EnergyHardwareBench/ehb-core/documentation/SUMMARY.md

# Table of contents

* [Projects](README.md)

## QUASAR-MS

* [Overview](quasar-ms/quickstart.md)
* [Mass Spectrometer & Vacuum System](quasar-ms/mass-spectrometer-and-vacuum-system.md)
* [Gas Processing & Sampling System](quasar-ms/gas-processing-and-sampling-system.md)
* [System Startup, and Tuning](quasar-ms/system-startup-and-tuning.md)
* [Calibration](quasar-ms/calibration.md)
* [Data](quasar-ms/publish-your-docs.md)
* [Taking a Measurement](quasar-ms/taking-a-measurement.md)
* [Tips + Tricks](quasar-ms/tips-+-tricks.md)
* [Support](quasar-ms/support.md)
* [Coming Soon](quasar-ms/coming-soon.md)

## Electrochemical Test Cells

* [Observable H Flow Cell](electrochemical-test-cells/observable-h-flow-cell.md)
* [Coming Soon](electrochemical-test-cells/coming-soon.md)
* [Editor](electrochemical-test-cells/editor.md)

## Resources

* [General Resources](resources/general-resources.md)
