EnergyHardwareBench/ehb-core/documentation/quasar-ms/coming-soon.md

---
description: List of Planned Changes
---

# Coming Soon

Thank you for your patience while we update documentation during our beta release. We plan to release more documentation by August 2026 on the following topics for QUASAR-MS.

* Detailed system startup, and tuning instructions
* Step-by-step calibration instructions and sample calibration data, data processing scripts for calibration
* Experimental methods, data collection instructions, software for data collection, scripts for data processing
* Scripts for testing individual hardware components, and plotting data
* Updated BoM for simplified version of QUASAR-MS
* Discord support server and github code repositories&#x20;
* Tips and tricks&#x20;

In the meantime, join our Email List or RSS Feed for updates!
