EnergyHardwareBench/ehb-core/documentation/quasar-ms/publish-your-docs.md

---
hidden: true
layout:
  width: default
  title:
    visible: true
  description:
    visible: true
  tableOfContents:
    visible: true
  outline:
    visible: true
  pagination:
    visible: true
  metadata:
    visible: true
  tags:
    visible: true
  actions:
    visible: true
  anchors:
    visible: true
---

# Data

**THIS IS ALSO WHERE WE EXPLAIN mdot - mdot etc ...**&#x20;

**Curves we will publish**

* calibration cruves and procedures
  * calibration procedure&#x20;
* stability curves—pressure stability and etc&#x20;
* reset time and rise time data
* Errors spreadsheet&#x20;
* Experiment example data
  * procedure for experiment... turn on turn off
* pump down and bakeout procedure and etc ...&#x20;

Sections order:

* Design details&#x20;
* BoM and CAD
* Assembly&#x20;
* Setup Calibration&#x20;
* Data
* Tips and Tricks
