EnergyHardwareBench/ehb-core/documentation/resources/general-resources.md

---
description: Links to General Resources of Value to the Electrochemistry Community
---

# General Resources

{% hint style="info" %}
More resources are coming soon!
{% endhint %}

#### Design Resources

[FUNdaMENTALs of Design](https://meddevdesign.mit.edu/fundamentals-of-design/)—a great resource on precision engineering design and ideation.&#x20;

#### XPS Characterization

These resources were shown to us by Libby Shaw at the MIT Materials Research Lab (MRL), thanks Libby!

[ThermoFischer Scientific XPS Database](https://www.thermofisher.com/us/en/home/materials-science/learning-center/periodic-table.html)

[NIST X-Ray Photoelectron Spectroscopy Database](https://srdata.nist.gov/)

[XPS Reference Pages](https://www.xpsfitting.com/)

#### Recommended Textbooks

Practical Electronics for Inventors, 4th Edition, Paul Scherz and Simon Monk

Principles of Power Electronics, John G. Kassakian, David J. Perreault, George C. Verghese, Martin F. Schlecht

Shigley's Mechanical Engineering Design, by Joseph Edward Shigley and Richard G. Budynas
