EnergyHardwareBench/ehb-core/documentation/.gitbook/assets/Asset 41@300x.png

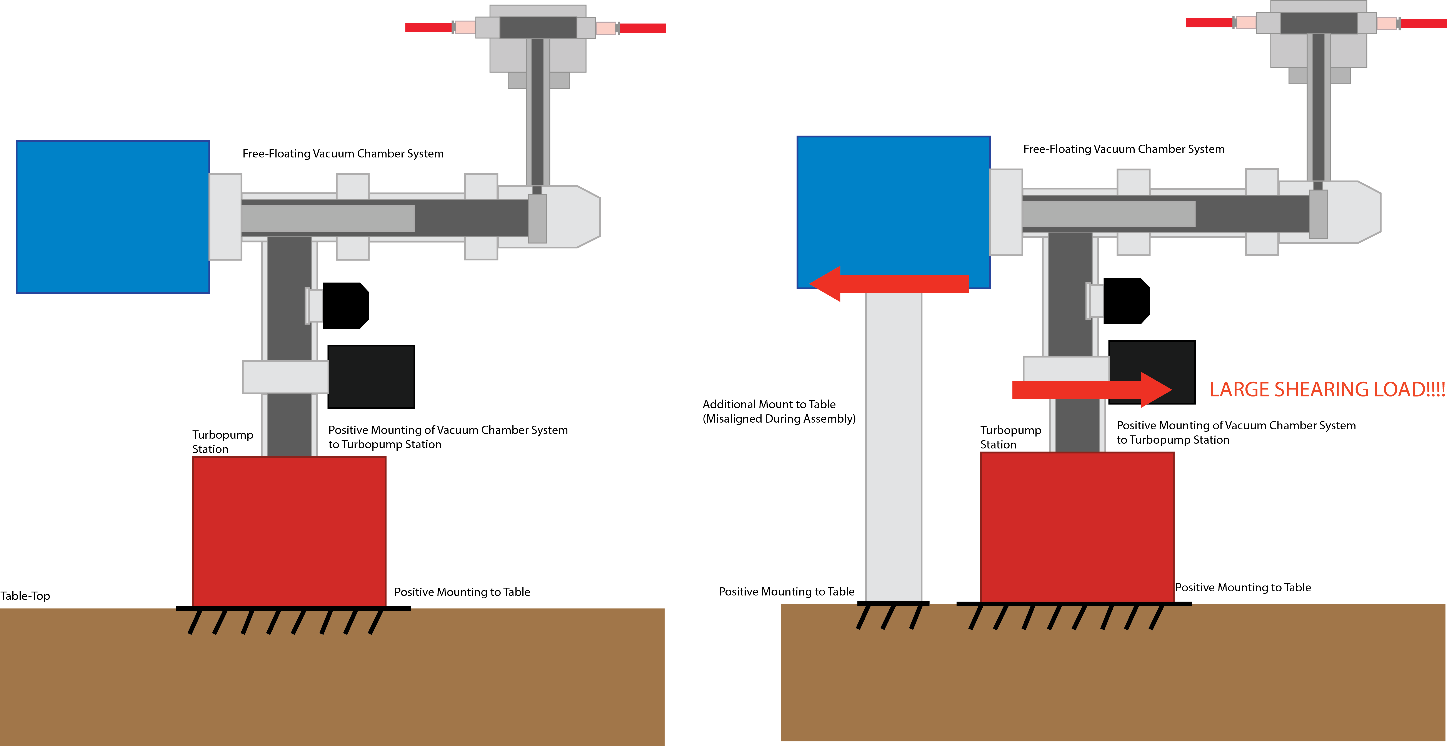
documentation/.gitbook/assets/Asset 41@300x.png
