EnergyHardwareBench/ehb-core/documentation/.gitbook/assets/Asset 56@300x.png

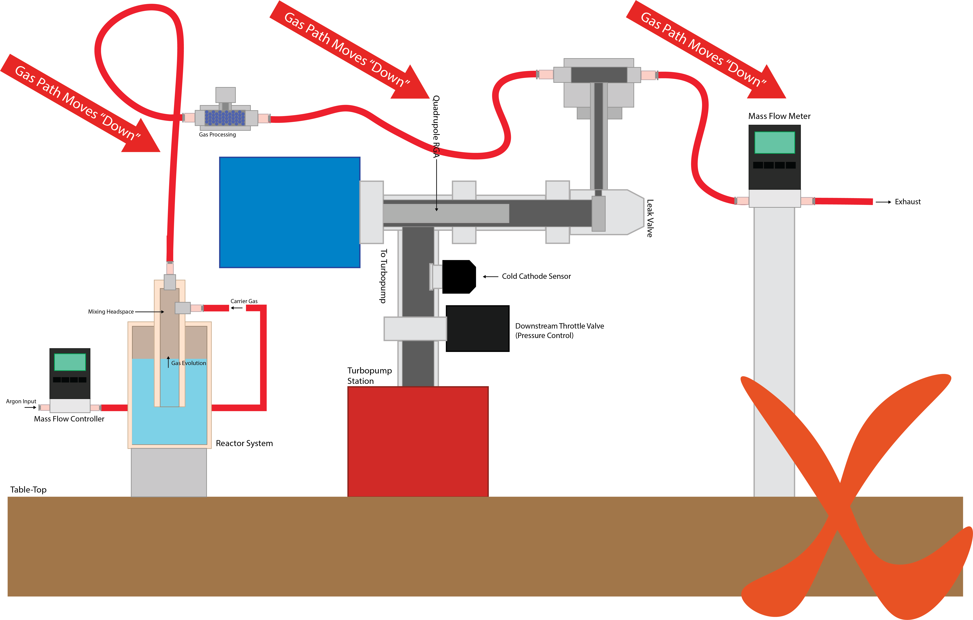
documentation/.gitbook/assets/Asset 56@300x.png
