EnergyHardwareBench/ehb-core/documentation/.gitbook/assets/Figure_2.png

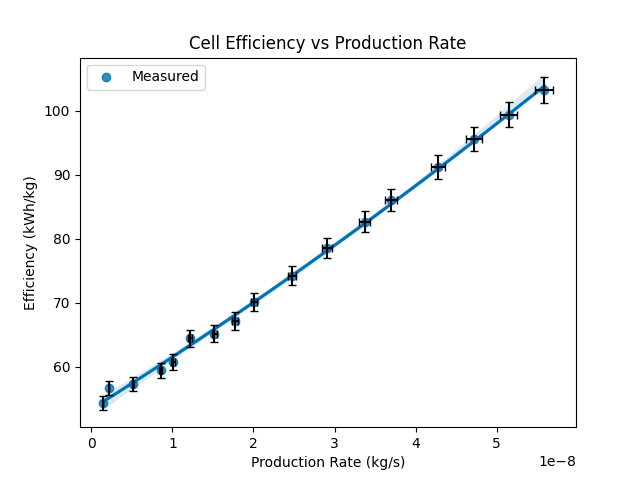
documentation/.gitbook/assets/Figure_2.png
