EnergyHardwareBench/ehb-core/documentation/.gitbook/assets/image (3).png

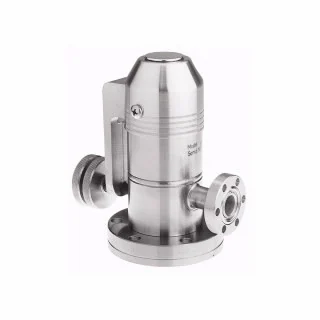
documentation/.gitbook/assets/image (3).png
