EnergyHardwareBench/ehb-core/documentation/.gitbook/assets/image (4).png

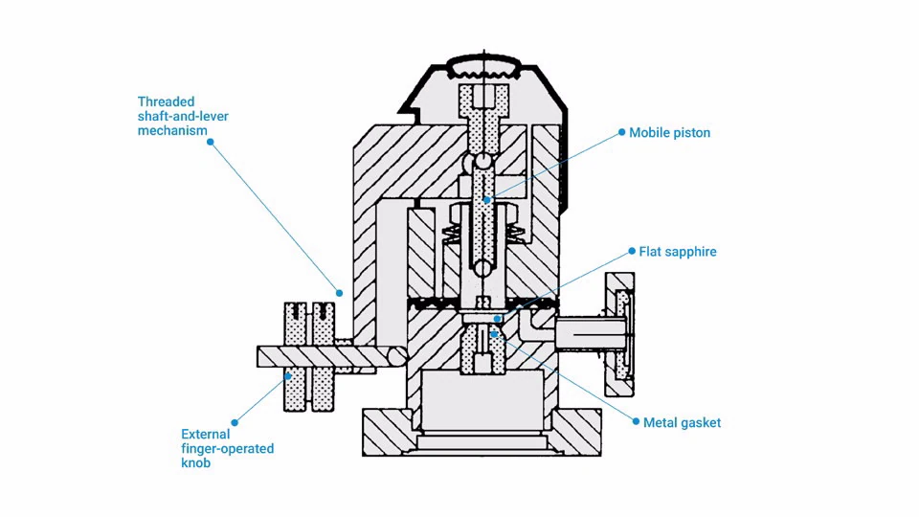
documentation/.gitbook/assets/image (4).png
