EnergyHardwareBench/ehb-core/documentation/.gitbook/assets/image (5).png

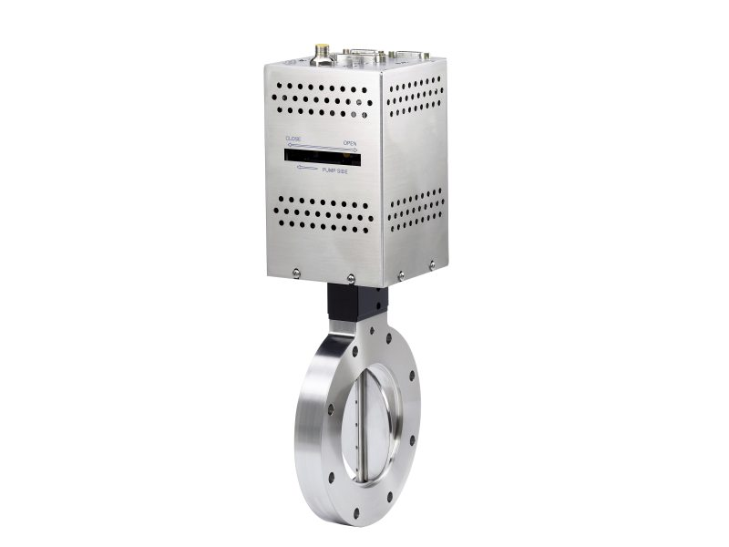
documentation/.gitbook/assets/image (5).png
