EnergyHardwareBench/ehb-core/documentation/.gitbook/assets/IMG_6685 (1).jpeg

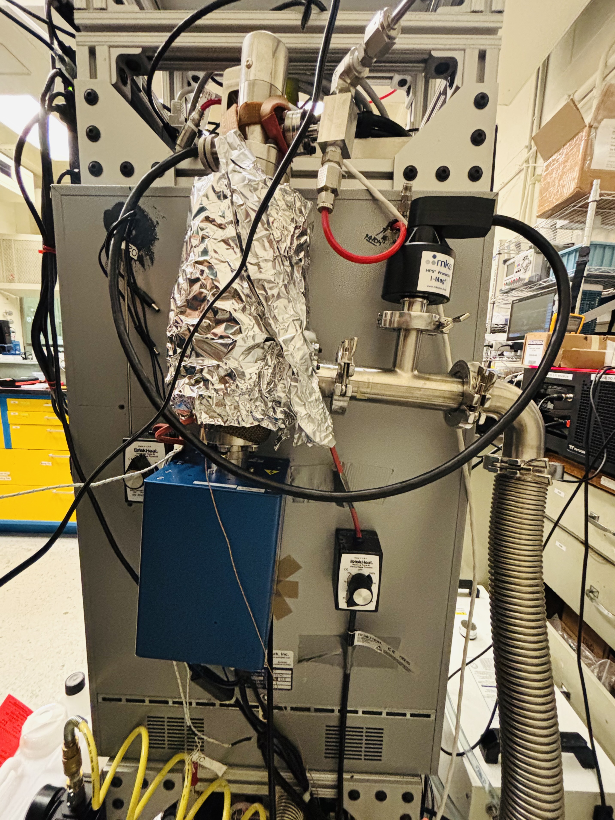
documentation/.gitbook/assets/IMG_6685 (1).jpeg
