EnergyHardwareBench/ehb-core/documentation/.gitbook/assets/section.png

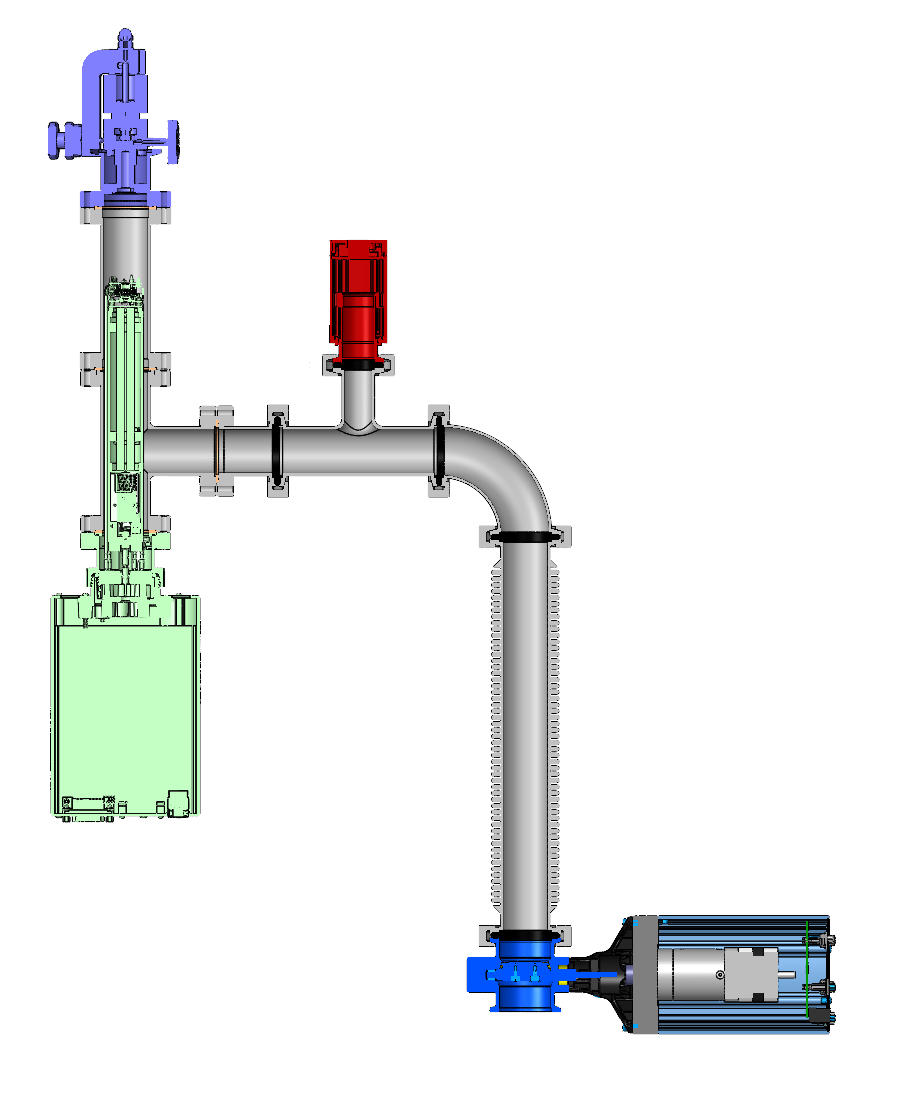
documentation/.gitbook/assets/section.png
