EnergyHardwareBench/ehb-core/thanks/untitled/.gitbook/assets/image.png

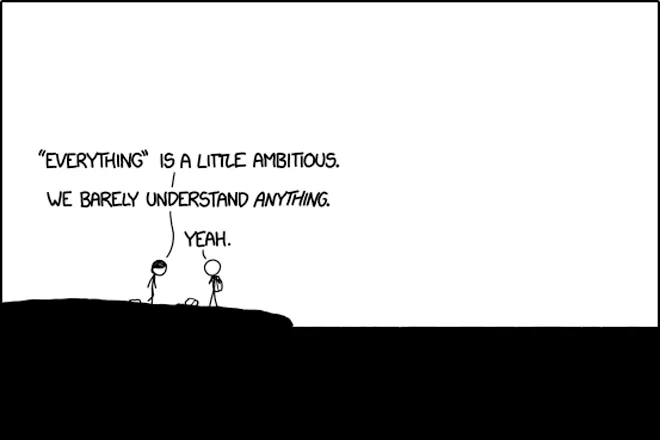
thanks/untitled/.gitbook/assets/image.png
