EnergyHardwareBench/ehb-core/documentation/.gitbook/assets/full_cell_assem.STEP

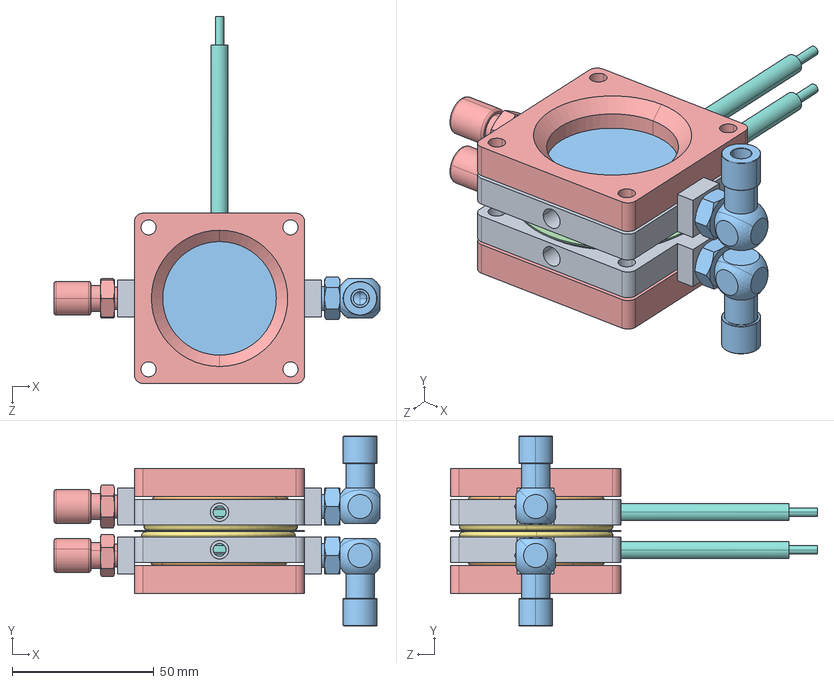
[picture p64: CAD file, 2026-10-14]
documentation/.gitbook/assets/full_cell_assem.STEP
114.8 x 66.8 x 129.3 mm
hydrogen_compartment x 2
2407N212_Stainless Steel Push-to-Connect Tube Fitting for Chemicals_2407N212 x 2
2407N122_Stainless Steel Push-to-Connect Tube Fitting for Chemicals_2407N122 x 2
9319K182_FEP-Encapsulated Silicone O-Ring_9319K182 x 2
9319K187_FEP-Encapsulated Silicone O-Ring_9319K187 x 2
electrode_holder x 2
nickle_electrode x 2
9319K155_FEP-Encapsulated Silicone O-Ring_9319K155 x 2
quartz_sheet x 2
zirfon_perl_500
end_caps x 2
