EnergyHardwareBench/ehb-core/documentation/.gitbook/assets/ST.SLDPRT

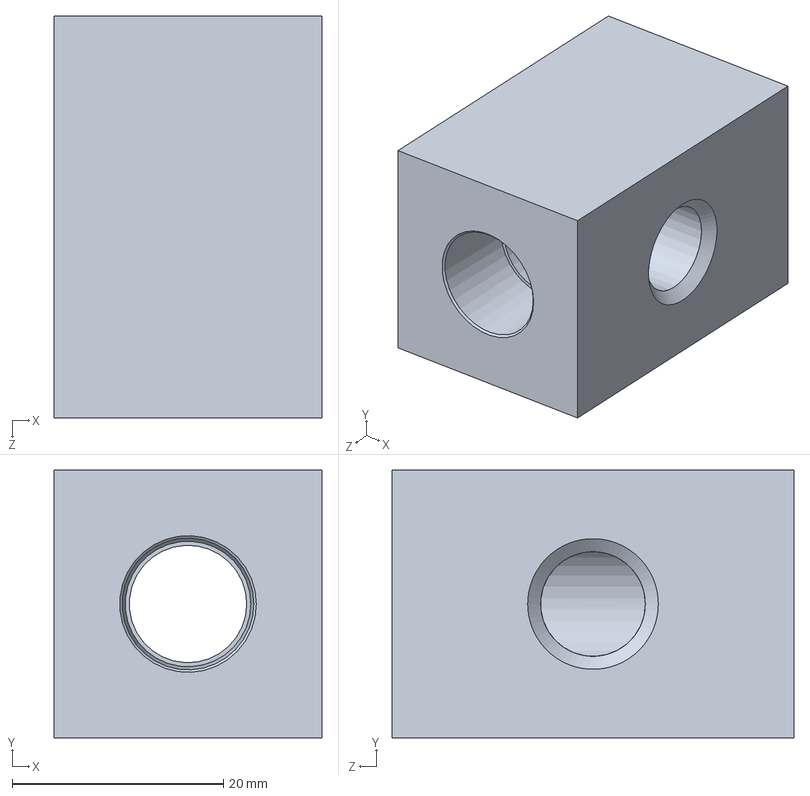
[picture p65: CAD file, 2026-10-14]
documentation/.gitbook/assets/ST.SLDPRT
25.4 x 25.4 x 38.1 mm
