EnergyHardwareBench/ehb-core/documentation/electrochemical-test-cells/coming-soon.md

---
description: List of Planned Changes
---

# Coming Soon

Thank you for your patience while we update documentation during our beta release. We plan to release more documentation by August 2026 on the following topics for Electrochemical Test Cells.

* Detailed characterization data for the flow H-Cell including polarization and efficiency curves, CV curves, and EIS data.
* Design documentation for the full bubbler-pump system for the mini electrolysis system.&#x20;

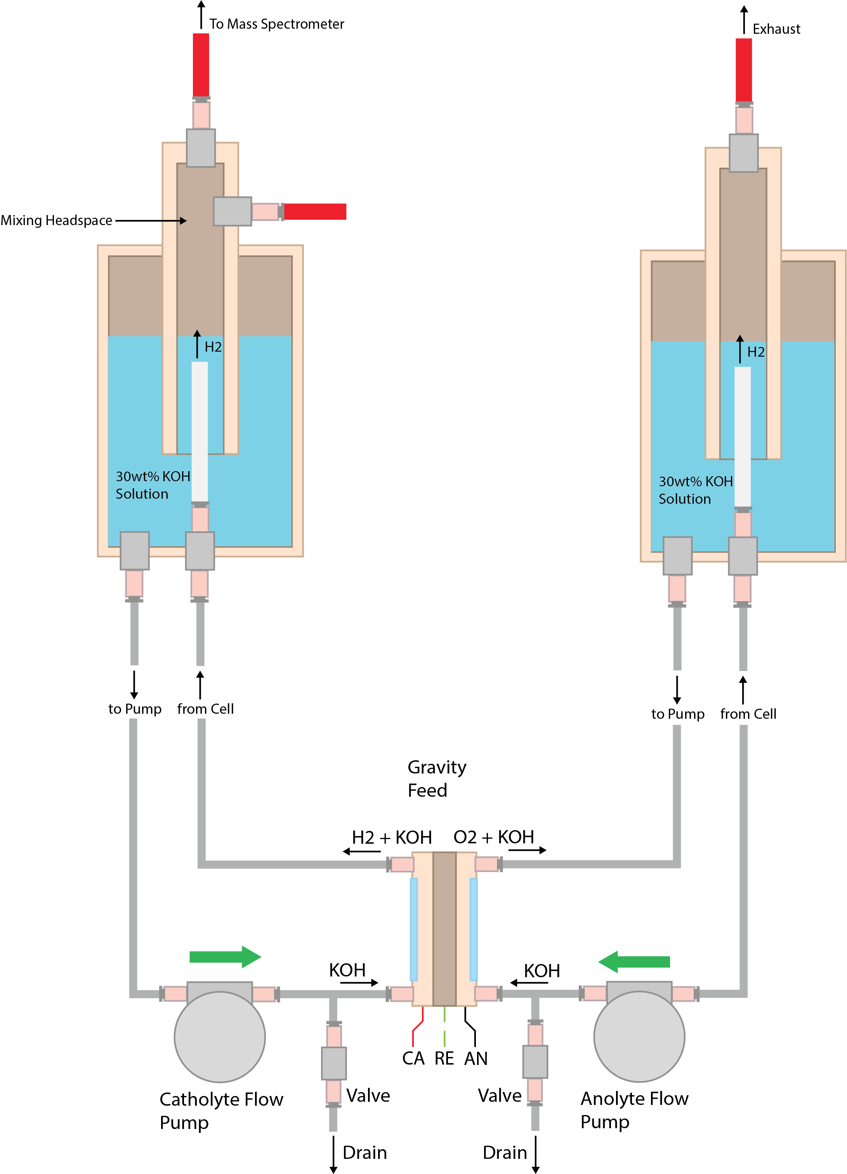
[picture p66: documentation/.gitbook/assets/Asset 74@300x.png]
<figure><figcaption></figcaption></figure>

* Deatiled design of operando cells and coupling of cells to operando characterization equipment and the QUASAR-MS.

In the meantime, join our Email List or RSS Feed for updates!
