EnergyHardwareBench/ehb-core/documentation/electrochemical-test-cells/editor.md

---
hidden: true
icon: pen-to-square
layout:
  width: default
  title:
    visible: true
  description:
    visible: true
  tableOfContents:
    visible: true
  outline:
    visible: true
  pagination:
    visible: true
  metadata:
    visible: true
  tags:
    visible: true
  actions:
    visible: true
  anchors:
    visible: true
---

# Editor

**POINTS TO MAKE**

* the windows are interchangeable !&#x20;
  * sapphire or quartz&#x20;
* O-rings are replaceable, compression is correct
  * how often to replace them!!!!
* Compatibility matrix with key electrolytes&#x20;

**add the bubbler situation !**&#x20;

and simultaneously?&#x20;

while also being compatible with surface-sensitive techniques such as Raman/SERS/SEIRAS spectrometers

* Coupling to operando equipment
* &#x20;simultaneous coupling to raman&#x20;
* translatability to the beamline&#x20;

Along with easier coupling to , open-source test cells provide a standardized platform for widely-studied reactions. With the design of

_STANDARDIZED TEST CELLS WITH KNOWN PUBLISHED DATA CURVES ..._&#x20;

* publish ALL the data!!!&#x20;

**Data we will publish**

* CV Curves — with scan rate and REF electrode data etc&#x20;
* EIS at different overpotentials&#x20;
* Electrode prep procedure&#x20;
* ex-situ XPS data; and electrode prep procedure for XPS&#x20;
* Polarization cruve of the cell
* efficiency curve&#x20;
* overpotentials with respect to the RE&#x20;
* pressures in the chamber (like EVERYTHING WE PLOT)
* FE with respect to average current&#x20;
