EnergyHardwareBench/ehb-core/documentation/quasar-ms/calibration.md

---
hidden: true
---

# Calibration

### System Error Analysis
