EnergyHardwareBench/ehb-core/documentation/quasar-ms/taking-a-measurement.md

---
hidden: true
---

# Taking a Measurement

**HIGH SAMPLING RATE ON THE MFM**&#x20;

**OR THE USE OF NON-PERISTALTIC PUMPS !!! KNF FOR EXAMPLE!!!**&#x20;
