EnergyHardwareBench/ehb-core/updates/changelog/README.md

---
description: >-
  Key updates on new project and project status; log of "breaking changes" to
  software or critical hardware updates. Subscribe to the EHB RSS feed for
  notifications.
icon: clock-rotate-left
layout:
  width: wide
  title:
    visible: true
  description:
    visible: true
  tableOfContents:
    visible: false
  outline:
    visible: true
  pagination:
    visible: false
  metadata:
    visible: true
  tags:
    visible: true
  actions:
    visible: true
  anchors:
    visible: true
---

# Updates

{% updates format="full" %}
{% update date="2026-08-25" %}
## Hardware Submissions now Open

* We welcome any and all contributors to submit hardware documentation to be published on our site. Thank you for making energy science and education more accessible for all!
* Check out the [hardware submission form](https://forms.cloud.microsoft/pages/responsepage.aspx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\&route=shorturl) for full list of details, guidelines, and requirements.
{% endupdate %}

{% update date="2026-05-27" %}
## EHB Public Beta Released

* Initial documentation on QUASAR MS and Electrochemical Cells released, data, software, and detailed documentation set to release later this summer.&#x20;
* Please contact us at [hardware@mit.edu](mailto:hardware@mit.edu) for more information.
{% endupdate %}
{% endupdates %}
