EnergyHardwareBench/ehb-core/updates/changelog/SUMMARY.md

# Table of contents

* [Updates](README.md)
