EnergyHardwareBench/ehb-core/documentation/.gitbook/assets/IMG_6688.jpeg

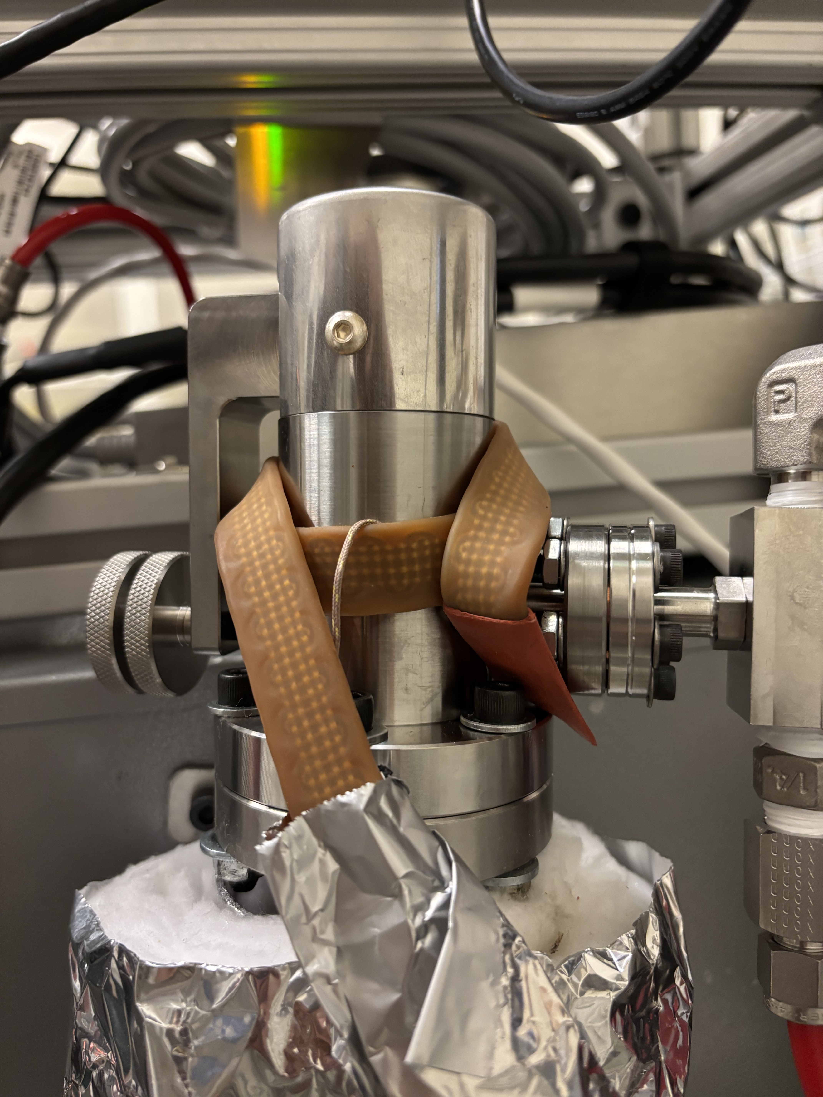
[picture p12: documentation/.gitbook/assets/IMG_6688.jpeg]
documentation/.gitbook/assets/IMG_6688.jpeg
