EnergyHardwareBench/ehb-core/documentation/.gitbook/assets/IMG_6692.jpeg

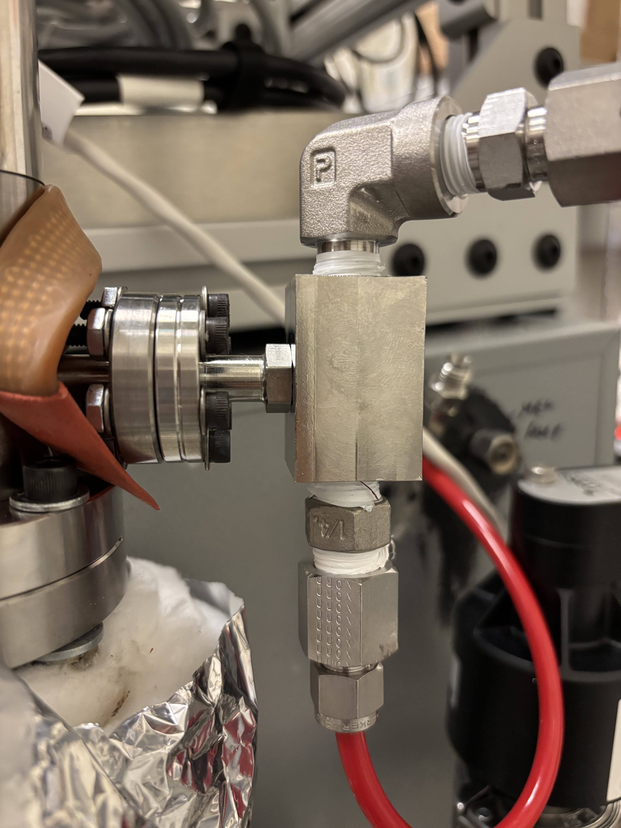
[picture p17: documentation/.gitbook/assets/IMG_6692.jpeg]
documentation/.gitbook/assets/IMG_6692.jpeg
