EnergyHardwareBench/ehb-core/documentation/.gitbook/assets/IMG_6696.jpeg

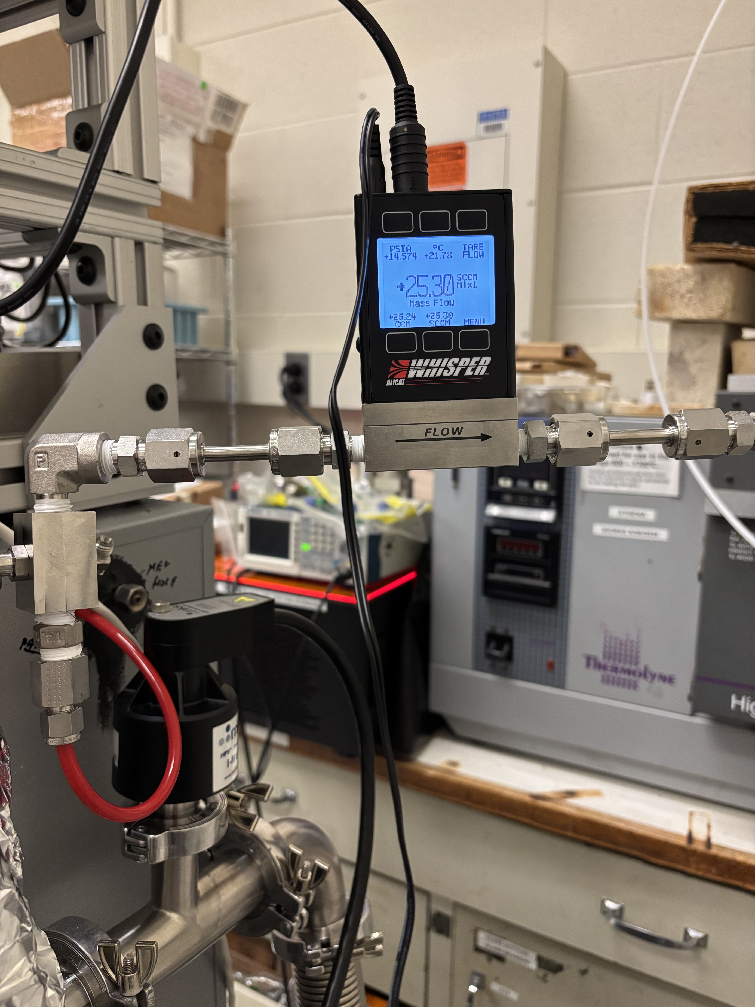
[picture p21: documentation/.gitbook/assets/IMG_6696.jpeg]
documentation/.gitbook/assets/IMG_6696.jpeg
