EnergyHardwareBench/ehb-core/documentation/.gitbook/assets/IMG_6682.jpeg

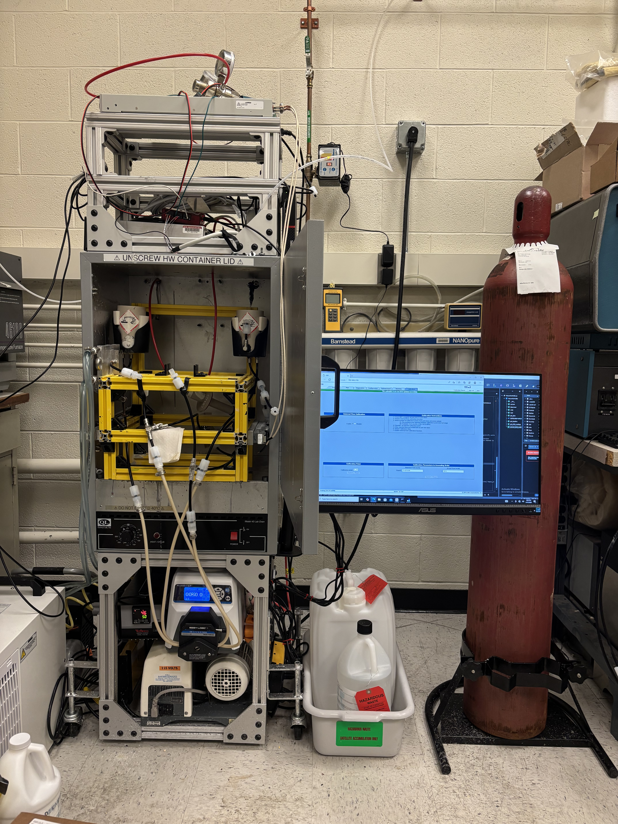
documentation/.gitbook/assets/IMG_6682.jpeg
