EnergyHardwareBench/ehb-core/documentation/.gitbook/assets/IMG_6701.jpeg

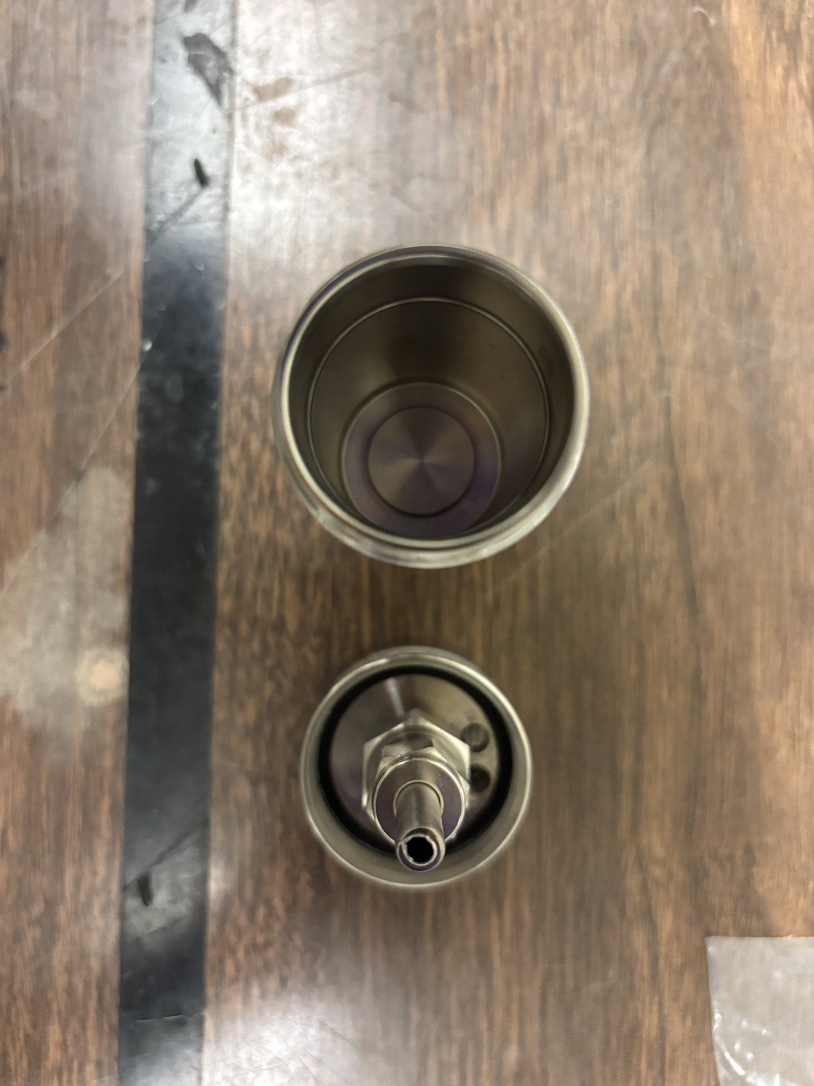
documentation/.gitbook/assets/IMG_6701.jpeg
