EnergyHardwareBench/ehb-core/documentation/.gitbook/assets/IMG_6691.jpeg

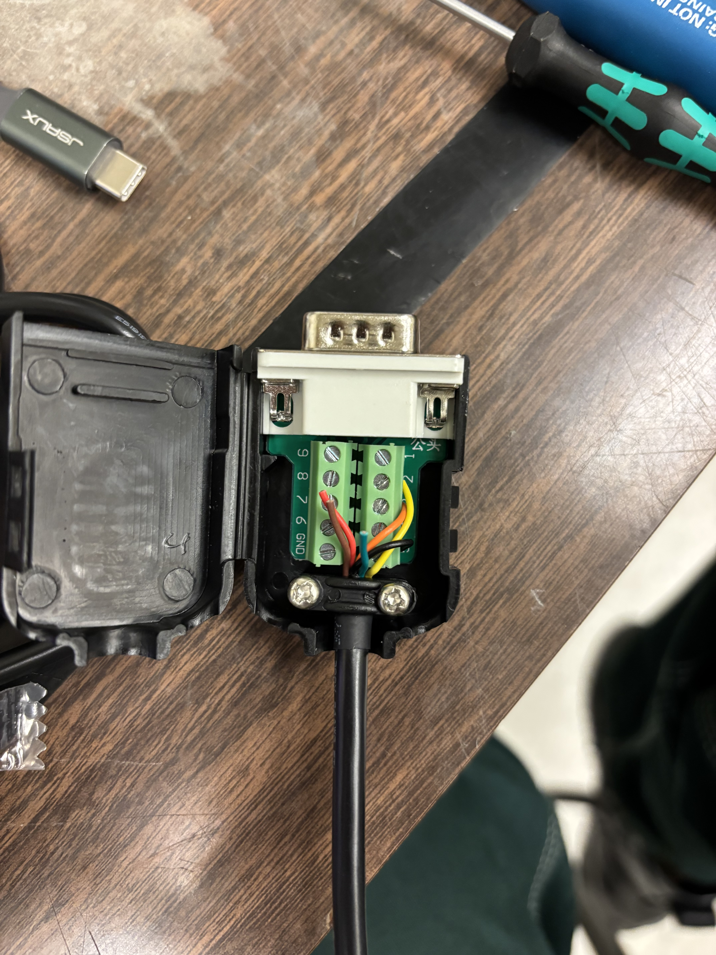
[picture p76: documentation/.gitbook/assets/IMG_6691.jpeg]
documentation/.gitbook/assets/IMG_6691.jpeg
